COSMIIC-Inc/Implantables-Electrodes/Mechanical Design CAD Files/Epimysial MES Electrode Cable/STEP Files/NNP-DWG-140-014-000 Electrode, EPI, Disk.STEP

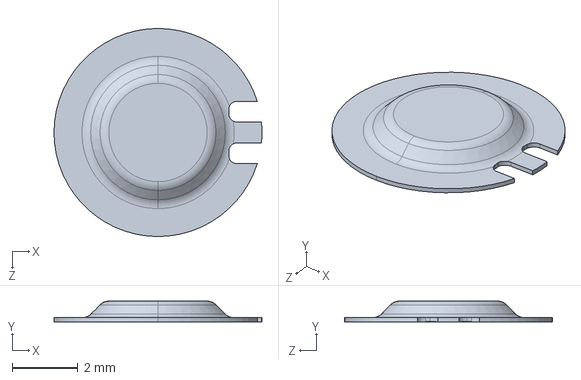
[picture p1: CAD file, 2024-06-29]
Mechanical Design CAD Files/Epimysial MES Electrode Cable/STEP Files/NNP-DWG-140-014-000 Electrode, EPI, Disk.STEP
6.35 x 0.635 x 6.35 mm
