COSMIIC-Inc/Implantables-Electrodes/Mechanical Design CAD Files/Epimysial MES Electrode Cable/Drawing PDFs/NNP-DWG-140-014-000 Electrode, EPI, Disk.pdf

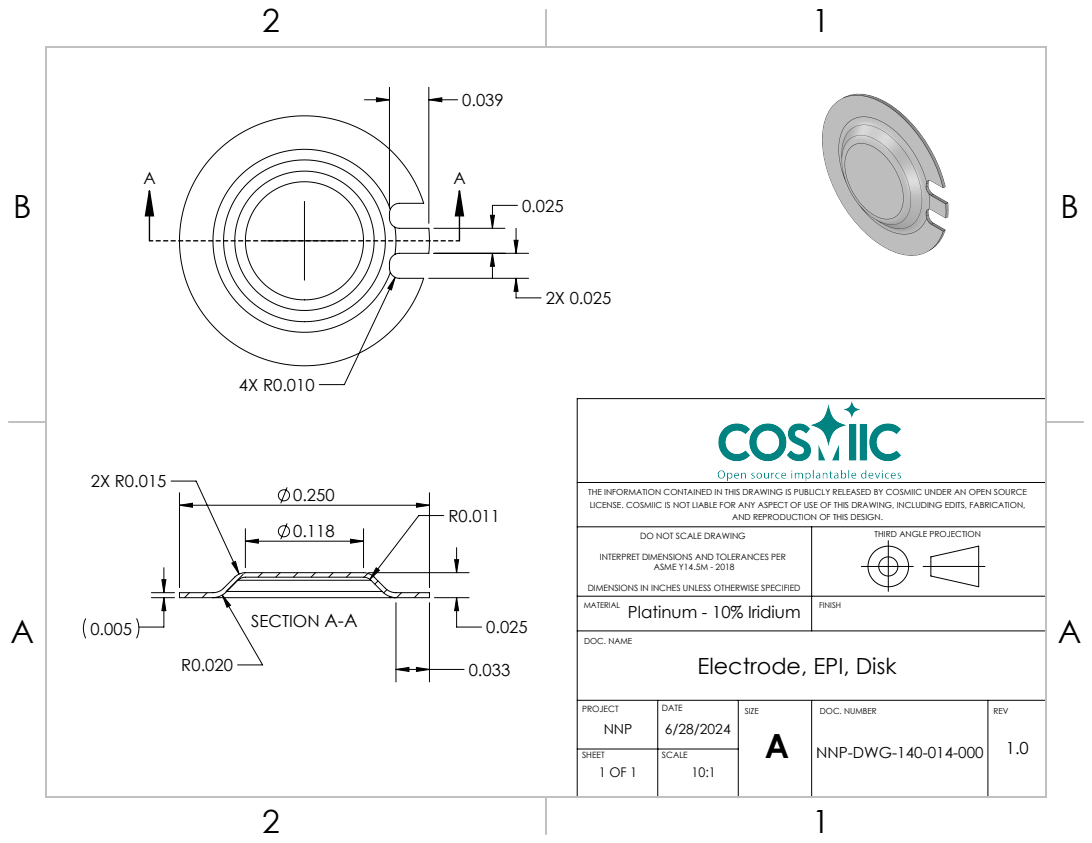
[picture p1: page 1]
SECTION A-A A; Platinum - 10% Iridium; NNP-DWG-140-014-000 1.0; ASME Y14.5M - 2018; DOC. NAME; DOC. NUMBER; REV; Electrode, EPI, Disk

THE INFORMATION CONTAINED IN THIS DRAWING IS PUBLICLY RELEASED BY COSMIIC UNDER AN OPEN SOURCE
LICENSE. COSMIIC IS NOT LIABLE FOR ANY ASPECT OF USE OF THIS DRAWING, INCLUDING EDITS, FABRICATION,

AND REPRODUCTION OF THIS DESIGN.

DO NOT SCALE DRAWING

THIRD ANGLE PROJECTION

INTERPRET DIMENSIONS AND TOLERANCES PER

DIMENSIONS IN INCHES UNLESS OTHERWISE SPECIFIED
