COSMIIC-Inc/Implantables-Electrodes/Mechanical Design CAD Files/IM Stim Electrode Cable/SolidWorks Native Files/NNP-DWG-140-019-002 Electrode, IM, Stim, Coil.SLDPRT

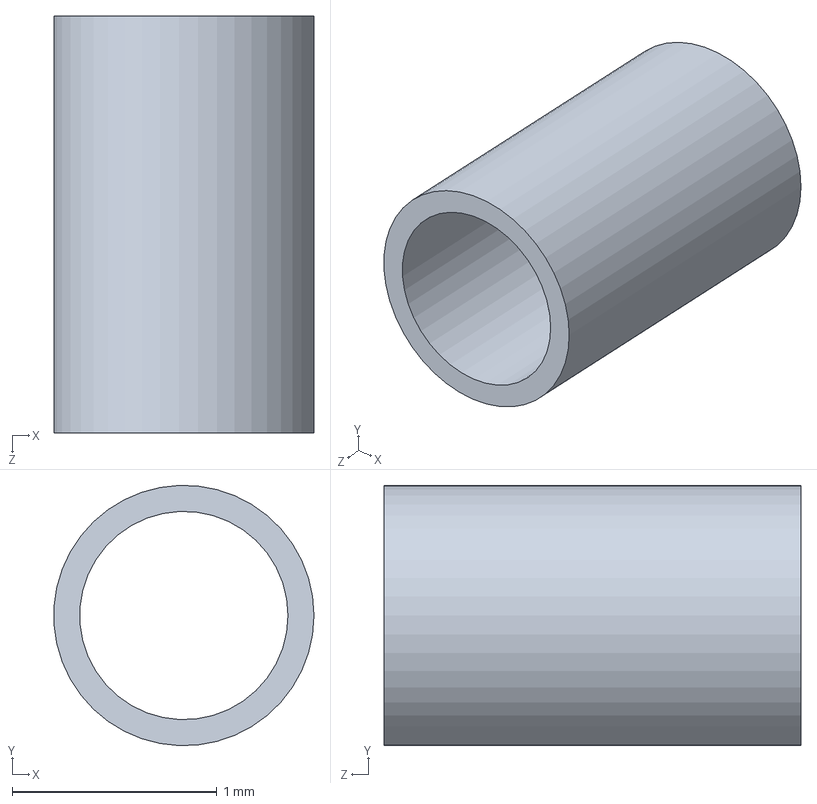
[picture p1: CAD file, 2024-07-09]
Mechanical Design CAD Files/IM Stim Electrode Cable/SolidWorks Native Files/NNP-DWG-140-019-002 Electrode, IM, Stim, Coil.SLDPRT
1.27 x 1.27 x 2.03 mm
