COSMIIC-Inc/Implantables-Electrodes/Mechanical Design CAD Files/IM-MES Electrode Cable/SolidWorks Native Files/NNP-DWG-140-018-000 Electrode, IM, Silicone Tubing Spacer.SLDPRT

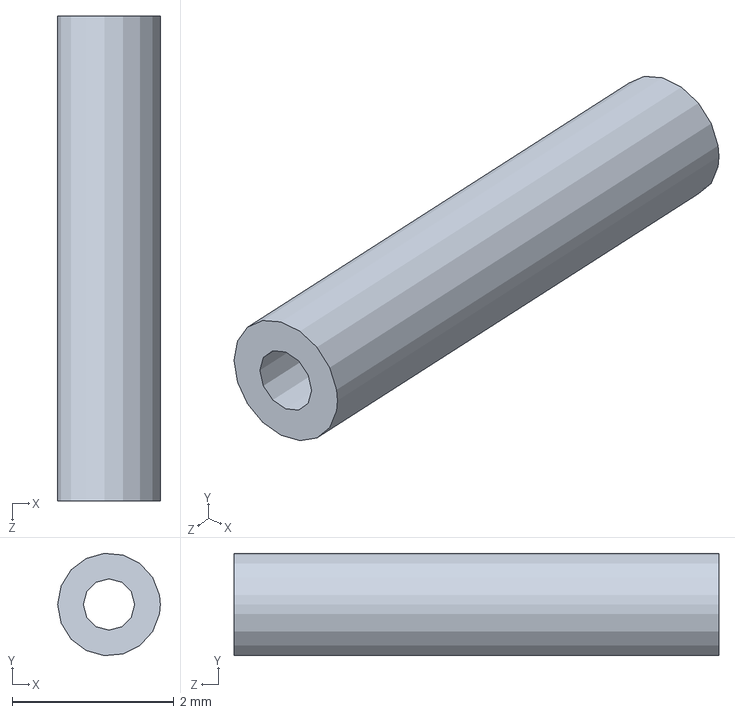
[picture p1: CAD file, 2024-07-09]
Mechanical Design CAD Files/IM-MES Electrode Cable/SolidWorks Native Files/NNP-DWG-140-018-000 Electrode, IM, Silicone Tubing Spacer.SLDPRT
1.27 x 1.26 x 5.99 mm
