COSMIIC-Inc/Implantables-Electrodes/Mechanical Design CAD Files/IM-MES Electrode Cable/STEP Files/NNP-DWG-140-018-000 Electrode, IM, Silicone Tubing Spacer.STEP

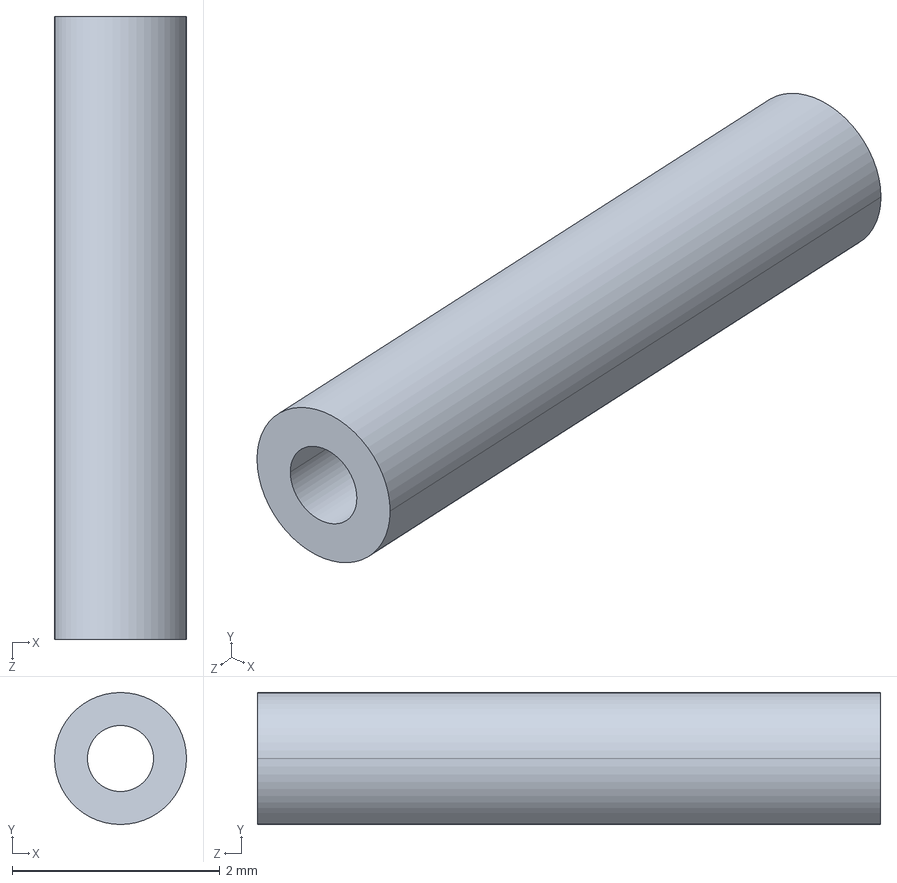
[picture p1: CAD file, 2024-07-09]
Mechanical Design CAD Files/IM-MES Electrode Cable/STEP Files/NNP-DWG-140-018-000 Electrode, IM, Silicone Tubing Spacer.STEP
1.27 x 1.27 x 5.99 mm
