COSMIIC-Inc/Implantables-Electrodes/Mechanical Design CAD Files/IM-MES Electrode Cable/STEP Files/NNP-DWG-140-013-001 Electrode, IM, MES, Prolene Barb.STEP

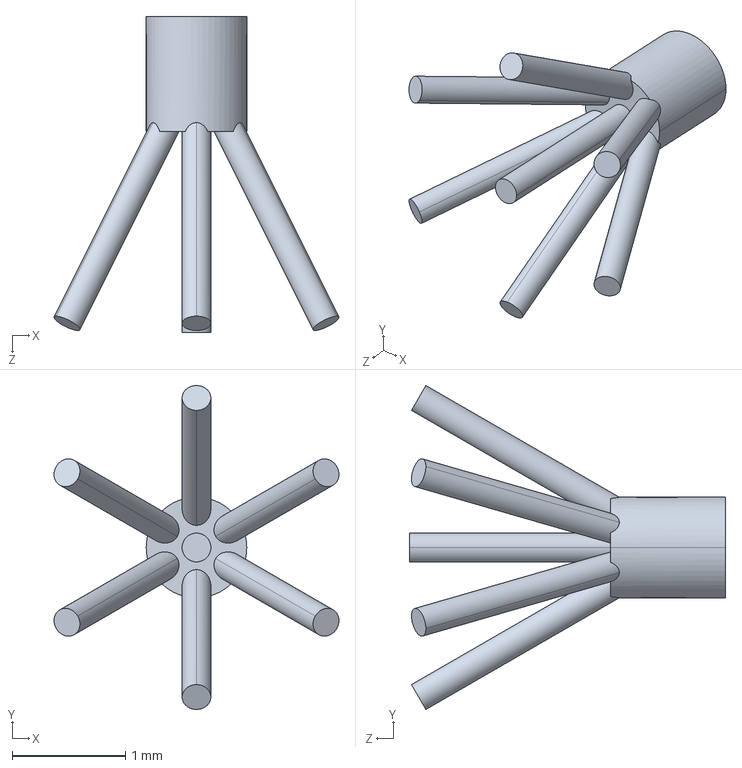
[picture p1: CAD file, 2024-07-09]
Mechanical Design CAD Files/IM-MES Electrode Cable/STEP Files/NNP-DWG-140-013-001 Electrode, IM, MES, Prolene Barb.STEP
2.52 x 2.86 x 2.79 mm
